shythm/uos-embedded-tracer/(commit log)

2023-11-21 feat: arduino motor control with uart
2023-12-14 Add min max power
